vk4kyt/TXRX_Relay_Board/RX_TXPCB.png

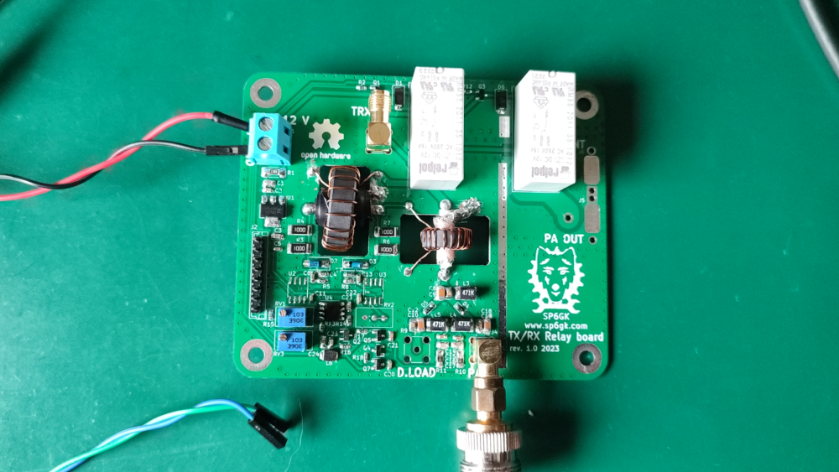
RX_TXPCB.png
