vk4kyt/TXRX_Relay_Board/TXRX_relay_board.kicad_pcb

## KiCad design TXRX_relay_board.kicad_pcb (2024-09-26)

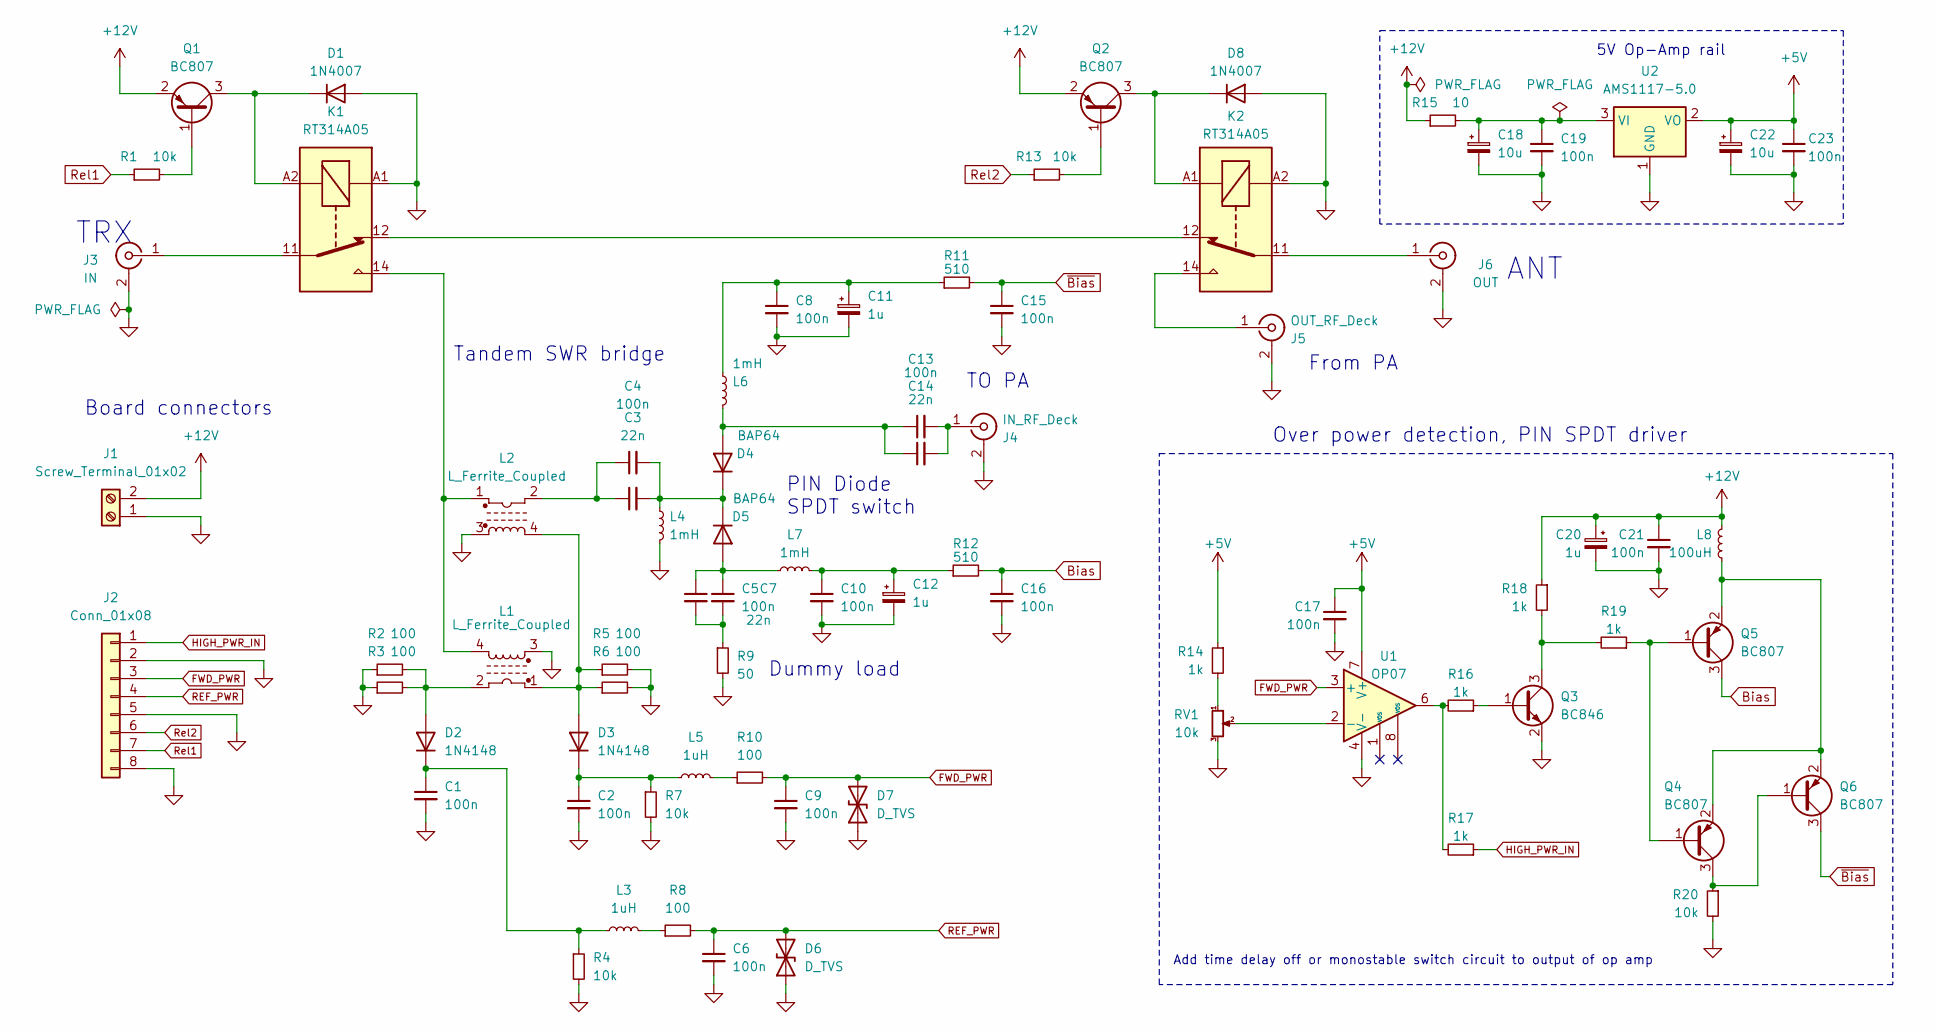
[picture p2: schematic TXRX_relay_board.kicad_sch, TX-RX Relay Board]

Parts:
C1, C2, C8, C9, C10, C15, C16, C17, C19, C21, C23: 100n; C_0603_1608Metric_Pad1.08x0.95mm_HandSolder; Ratings 100V; MPN MLASH168SB7104KTNA01
C3, C5, C14: 22n; C_0805_2012Metric_Pad1.18x1.45mm_HandSolder; Ratings 100V; MPN C0805C223M1RACAUTO
C4, C7, C13: 100n; C_0805_2012Metric_Pad1.18x1.45mm_HandSolder; Ratings 100V; MPN 08051C104KAT4A
C6: 100n; C_0603_1608Metric_Pad1.08x0.95mm_HandSolder; Ratings 100V; MPN 08051C104KAT4A
C11, C12, C20: 1u; C_0805_2012Metric_Pad1.18x1.45mm_HandSolder; Ratings 100V; MPN HMR212CC7105KG-T
C18, C22: 10u; C_0805_2012Metric_Pad1.18x1.45mm_HandSolder; Ratings 100V; MPN KGM21AR71C106MU
D1, D8: 1N4007; D_SMA; MPN MRA4007T3G
D2, D3: 1N4148; D_SOD-123F; MPN 1N4148W-G3-08
D4, D5: BAP64; D_SOD-323_HandSoldering; MPN BAP64-03,115
D6, D7: D_TVS; D_0805_2012Metric_Pad1.15x1.40mm_HandSolder; Ratings 30v; MPN EZA-EGCA50AV
J1: Screw_Terminal_01x02; TerminalBlock_bornier-2_P5.08mm; MPN 1548128
J2: Conn_01x08; JST_EH_B8B-EH-A_1x08_P2.50mm_Vertical; MPN B8B-EH-A(LF)(SN)(P)
J3: IN; SMA_Amphenol_901-144_Vertical; MPN 901-144-8RFX
J4: IN_RF_Deck; SMA_Amphenol_901-144_Vertical; MPN 901-144-8RFX
J5: OUT_RF_Deck; Coax_solder
J6: OUT; Coax_solder
K1, K2: RT314A05; Relay_SPDT_Schrack-RT1-16A-FormC_RM5mm; MPN RT314A05
L1: L_Ferrite_Coupled; FT82-61_trafo; Ratings N>=15; MPN 5961000601
L2: L_Ferrite_Coupled; FT50-61_trafo; Ratings N>=15; MPN 5961000301
L3, L5: 1uH; L_0603_1608Metric_Pad1.05x0.95mm_HandSolder; MPN ILSB0603ERR10K
L4, L6, L7: 1mH; L_1812_4532Metric_Pad1.30x3.40mm_HandSolder; Ratings 100V; MPN ISC1812ER102K
L8: 100uH; L_1206_3216Metric; MPN ILSB1206ER1R0K
Q1, Q2, Q4, Q5, Q6: BC807; SOT-23; MPN BC807-40-QVL
Q3: BC846; SOT-23; MPN BC846A
R1, R4, R7, R13, R20: 10k; R_0603_1608Metric_Pad0.98x0.95mm_HandSolder; MPN RK73H1JTTDD1001F
R2, R3, R5, R6: 100; R_2010_5025Metric_Pad1.40x2.65mm_HandSolder; MPN RMC1/2-101JTE
R8, R10: 100; R_0603_1608Metric_Pad0.98x0.95mm_HandSolder; MPN CRG0603F100R
R9: 50; SMA_Amphenol_901-144_Vertical; Ratings Dummy Load; MPN 901-144-8RFX
R11, R12: 510; R_1206_3216Metric_Pad1.30x1.75mm_HandSolder; MPN AC0603FR-07510RL
R14, R16, R17, R18, R19: 1k; R_0603_1608Metric_Pad0.98x0.95mm_HandSolder; MPN RK73H1JTTDD1001F
R15: 10; R_2010_5025Metric_Pad1.40x2.65mm_HandSolder; Ratings 1.5W; MPN RNCL2010FT10R0
RV1: 10k; Potentiometer_Bourns_3296W_Vertical; MPN 3296W-1-103
U1: OP07; SOIC-8_3.9x4.9mm_P1.27mm; MPN OP-07DPSR
U2: AMS1117-5.0; SOT-223-3_TabPin2; MPN LM1117MPX-5.0/NOPB

Connections:
+5V: C17.1, C22.1, C23.1, R14.1, U1.7 (V+), U2.2 (VO)
+12V: C20.1, C21.1, J1.2, L8.1, Q1.2 (E), Q2.2 (E), R15.1, R18.1
Bias: C16.1, Q5.3 (C), R12.2
FWD_PWR: C9.1, D7.2 (A2), J2.3, R10.2, U1.3 (+)
GND: C1.2, C2.2, C6.2, C8.2, C9.2, C10.2, C11.2, C12.2, C15.2, C16.2, C17.2, C18.2, C19.2, C20.2, C21.2, C22.2, C23.2, D1.2 (A), D6.1 (A1), D7.1 (A1), D8.2 (A), J1.1, J2.2, J2.5, J2.8, J3.2 (Ext), J4.2 (Ext), J5.2 (Ext), J6.2 (Ext), K1.A1, K2.A2, L1.3, L2.3, L4.2, Q3.2 (E), R2.1, R3.1, R4.2, R5.2, R6.2, R7.2, R9.2, R20.2, RV1.3, U1.4 (V-), U2.1 (GND)
HIGH_PWR_IN: J2.1, R17.1
unnamed: C3.1, C4.1, L2.2
unnamed: C5.2, C7.2, R9.1
unnamed: C10.1, C12.1, L7.2, R12.1
unnamed: C8.1, C11.1, L6.1, R11.1
unnamed: D1.1 (K), K1.A2, Q1.3 (C)
unnamed: D2.2 (A), L1.2, R2.2, R3.2
unnamed: C1.1, D2.1 (K), L3.1, R4.1
unnamed: D3.2 (A), L1.1, L2.4, R5.1, R6.1
unnamed: C2.1, D3.1 (K), L5.1, R7.1
unnamed: C13.1, C14.1, D4.2 (A), L6.2
unnamed: C3.2, C4.2, D4.1 (K), D5.1 (K), L4.1
unnamed: C5.1, C7.1, D5.2 (A), L7.1
unnamed: D8.1 (K), K2.A1, Q2.3 (C)
unnamed: J3.1 (In), K1.11
unnamed: C13.2, C14.2, J4.1 (In)
unnamed: J5.1 (In), K2.14
unnamed: J6.1 (In), K2.11
unnamed: K1.12, K2.12
unnamed: K1.14, L1.4, L2.1
unnamed: L3.2, R8.1
unnamed: L5.2, R10.1
unnamed: Q1.1 (B), R1.2
unnamed: Q2.1 (B), R13.2
unnamed: Q3.1 (B), R16.1
unnamed: Q3.3 (C), R18.2, R19.2
unnamed: Q4.1 (B), Q5.1 (B), R19.1
unnamed: Q4.3 (C), Q6.1 (B), R20.1
unnamed: L8.2, Q4.2 (E), Q5.2 (E), Q6.2 (E)
unnamed: R14.2, RV1.1
unnamed: R16.2, R17.2, U1.6
unnamed: RV1.2, U1.2 (-)
unnamed: C18.1, C19.1, R15.2, U2.3 (VI)
REF_PWR: C6.1, D6.2 (A2), J2.4, R8.2
Rel1: J2.7, R1.1
Rel2: J2.6, R13.1
~Bias: C15.1, Q6.3 (C), R11.2

Notes on the sheet:
Board connectors
5V Op-Amp rail
From PA
TRX
ANT
Dummy load
TO PA
PIN Diode SPDT switch
Tandem SWR bridge
Add time delay off or monostable switch circuit to output of op amp
Over power detection, PIN SPDT driver

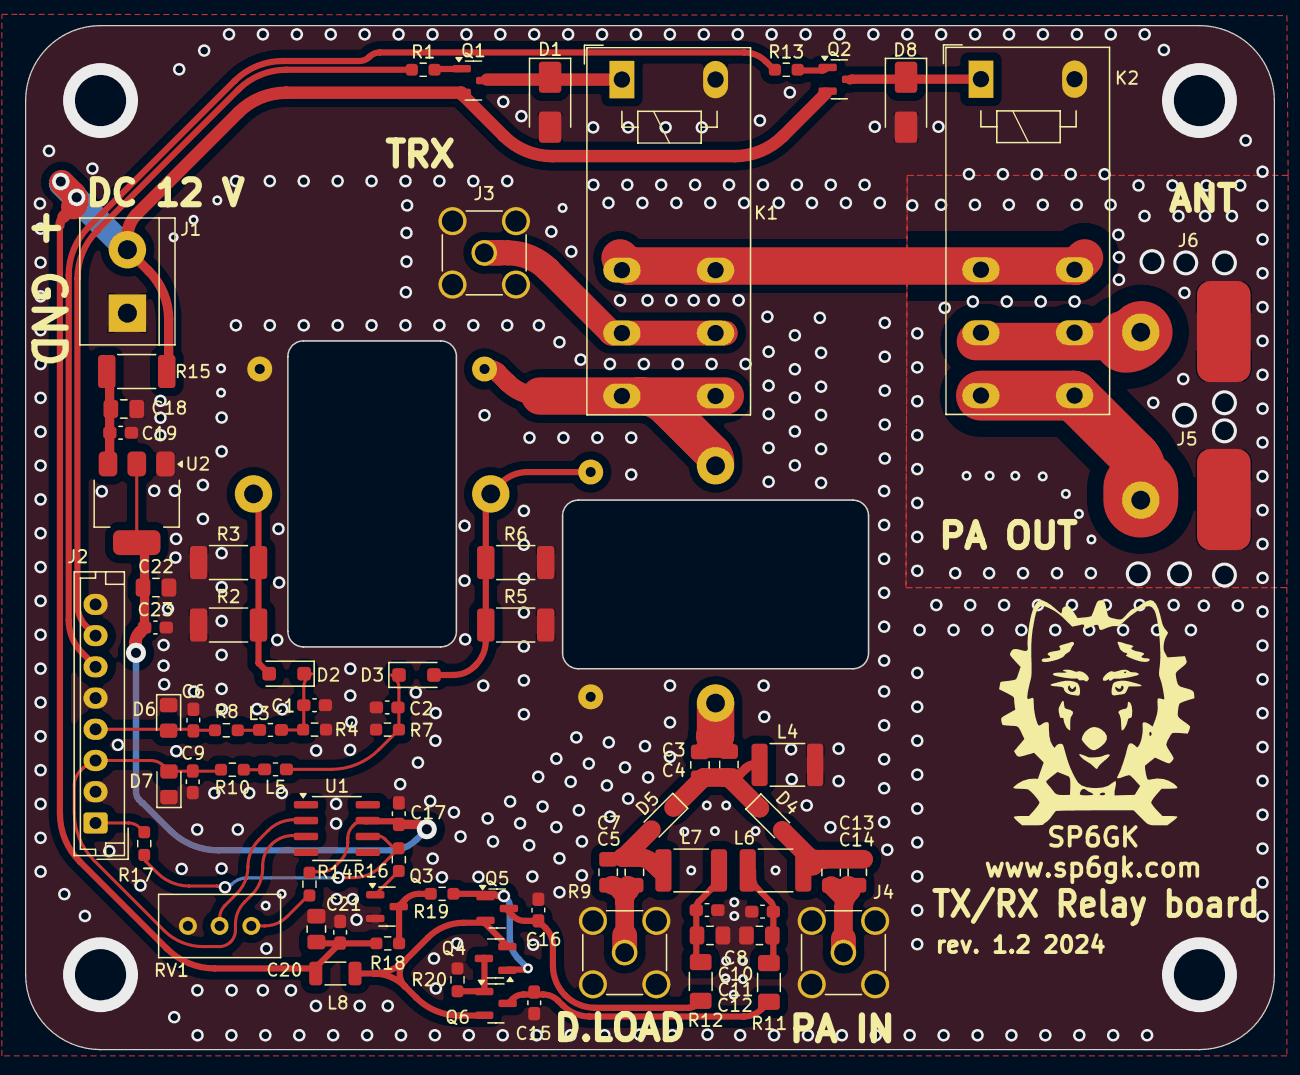
[picture p3: board TXRX_relay_board.kicad_pcb from above]

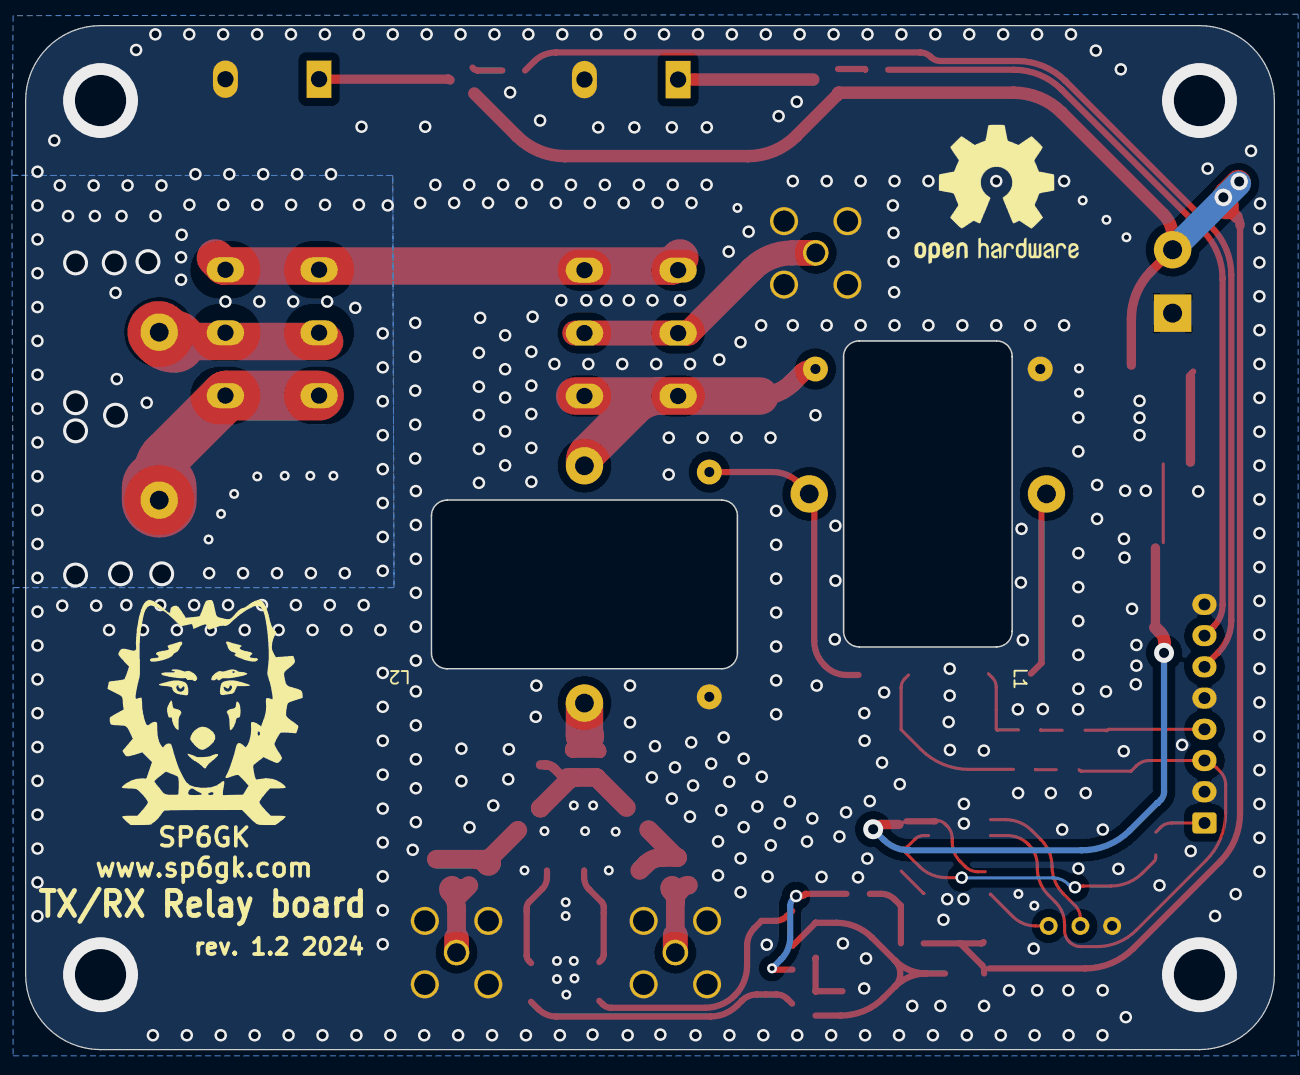
[picture p4: board TXRX_relay_board.kicad_pcb from below]

Board: 2 copper layers, 100.0 x 82.0 mm, 77 parts (3 on the bottom side), 42 nets.

Other parts of the board:
OSHW: OSHW-Logo2_14.6x12mm_SilkScreen
