vk4kyt/TXRX_Relay_Board/(commit log)

2024-09-11 Used ERC to fix minor Errors
    Used the ERC to fix minor error and warnings. Some relegated to "Excluded"
    [TXRX_relay_board.kicad_sch]
2024-09-11 DRC Update
    Design checked using DRC
    [TXRX_relay_board.kicad_pcb]
2024-09-14 Ready to Order
    Minor updates in preparation to order PCBs and components
    [TXRX_relay_board-B_Cu.gbr, TXRX_relay_board-B_Mask.gbr, TXRX_relay_board-B_Silks.gbr, TXRX_relay_board-Edge_Cuts.gbr, TXRX_relay_board-Edge_Cuts.gm1, TXRX_relay_board-F_Cu.gbr, TXRX_relay_board-F_Mask.gbr, TXRX_relay_board-F_Silks.gbr]
2024-09-26 All checks done, BOM updated
    All ERC and DRC checks have been run, and erros and or warnings resolved.
    BOM fully updated with Manufacturer part numbers (MPN) ready for order placement
    [TXRX_relay_board-B_Cu.gbr, TXRX_relay_board-B_Mask.gbr, TXRX_relay_board-B_Silks.gbr, TXRX_relay_board-Edge_Cuts.gbr, TXRX_relay_board-Edge_Cuts.gm1, TXRX_relay_board-F_Cu.gbr, TXRX_relay_board-F_Mask.gbr, TXRX_relay_board-F_Silks.gbr]
